SaabFAN/OpenSource-HW-RF-Signal-Generator-OSHW-RFSG-/Pictures/RF-Board_Rev1-Complete with Mods.jpg

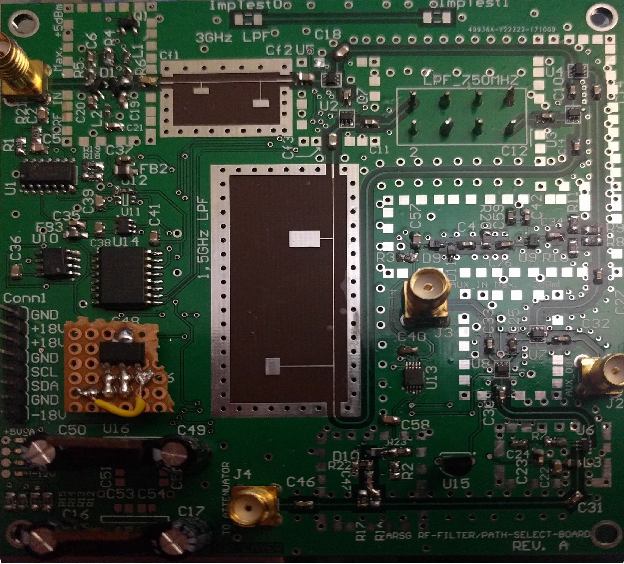
Pictures/RF-Board_Rev1-Complete with Mods.jpg
