SaabFAN/OpenSource-HW-RF-Signal-Generator-OSHW-RFSG-/Pictures/SignalGen_UI-Mockup.jpg

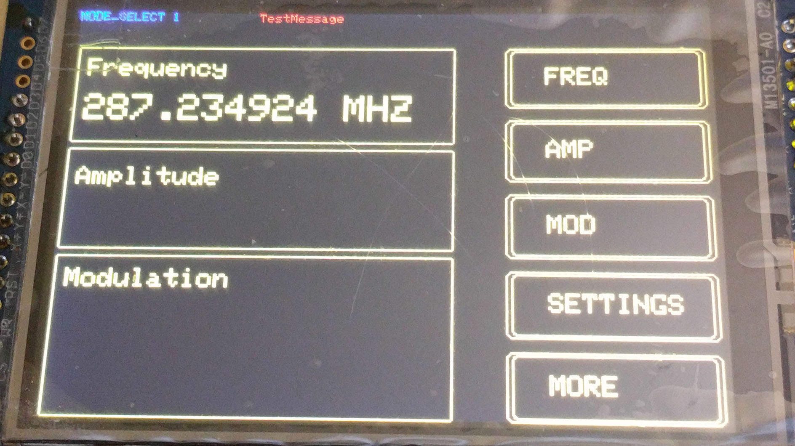
Pictures/SignalGen_UI-Mockup.jpg
