SaabFAN/OpenSource-HW-RF-Signal-Generator-OSHW-RFSG-/README.md

# OpenSource-HW-RF-Signal-Generator-OSHW-RFSG-
This is a open source hardware (and software) RF Signal Generator using readily available off the shelf-components. 

Corresponding EEVBlog Forum-Thread: http://www.eevblog.com/forum/oshw/open-source-hw-rf-signal-generator/

More info coming soon
