SaabFAN/OpenSource-HW-RF-Signal-Generator-OSHW-RFSG-/Schematics/Processor-Board/Processor-Board_CPU.pdf

InputRESET PA⁷ 17 PB⁰ 18 PB¹ 19 PB²/BOOT¹ 20 PB¹⁰ 21 | JTCK/SWCLK ³⁷ PB¹¹ 22 PA¹⁵/JTDI 38 PA³ 13 | VSS_1 23 PA⁴ 14 | PB³/JTDO ³⁹ PA⁵ 15 | VDD_1 24 PA⁶ 16 | PB⁴/JNTRST ⁴⁰ PB⁵ ⁴¹ PB⁶ ⁴² PB⁷ ⁴³ BOOT⁰ ⁴⁴ PB⁸ ⁴⁵ PB⁹ ⁴⁶ VSS_3 47 VDD_3 48

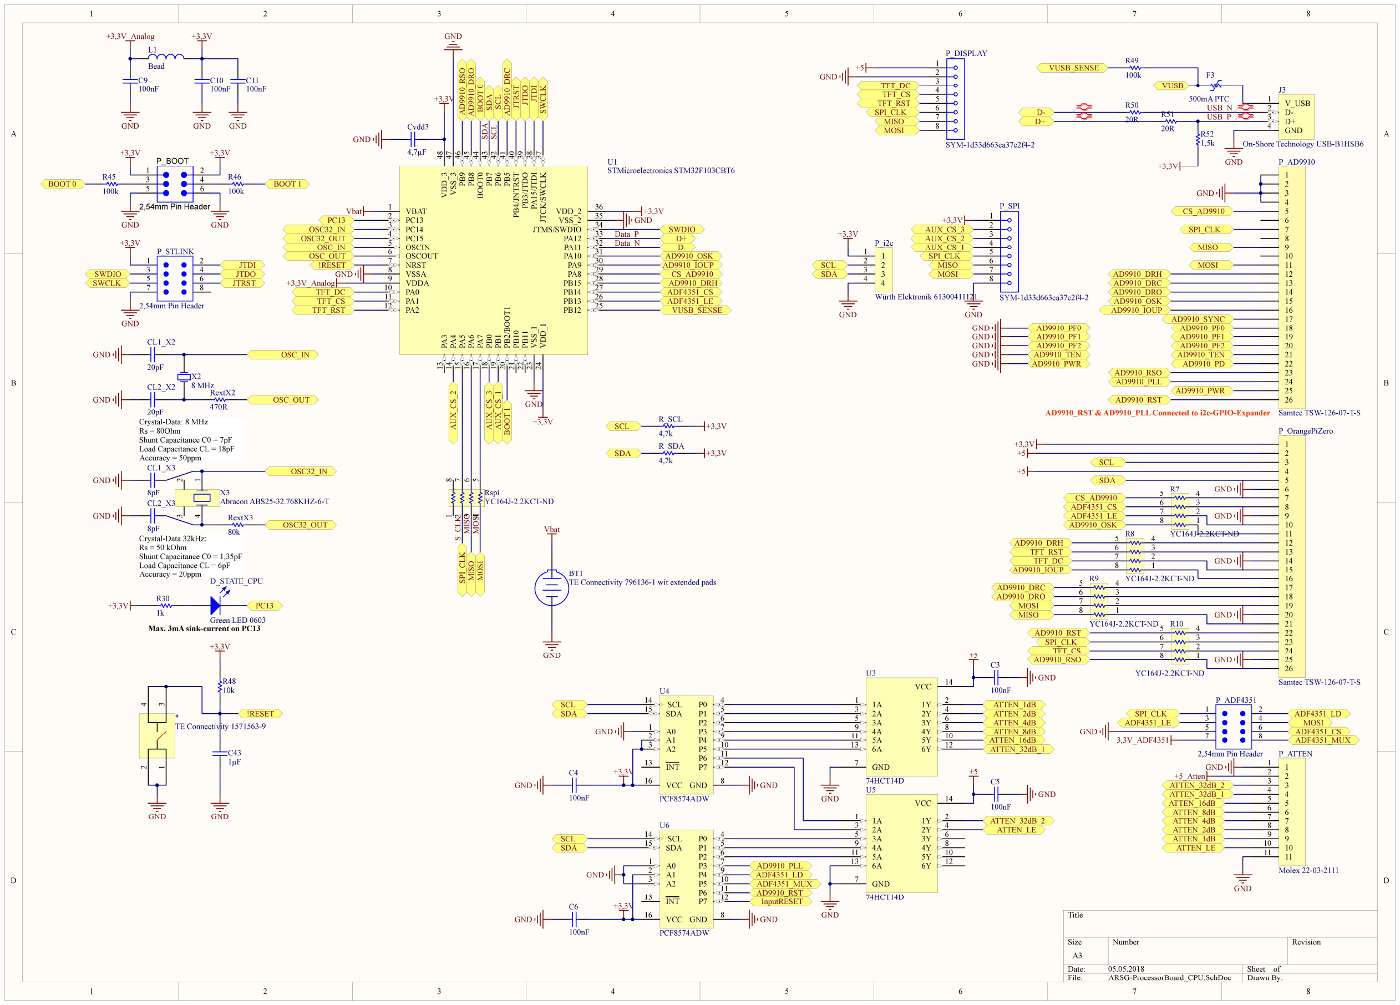
[picture p3: page 1]

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
Title

Size | Number | Revision
A3
Date: | 05.05.2018 | Sheet of
File: | ARSG-ProcessorBoard_CPU.SchDoc | Drawn By:

VBAT 1
PC13 2
PA12 33 PC14 3
PC15 4

JTMS/SWDIO 34

OSCIN 5
OSCOUT 6

VSS_2 35

NRST 7
VSSA 8

VDD_2 36

VDDA 9
PA0 10
PA1 11
PA2 12 | PB12 | 25 PB13 | 26 PB14 | 27 PB15 | 28 PA8 | 29 PA9 | 30 PA10 | 31 PA11 | 32

U1
STMicroelectronics STM32F103CBT6

RextX2
470R

CL1_X2

20pF
X2
CL2_X2 8 MHz

20pF

GND

GND

Crystal-Data: 8 MHz
Rs = 80Ohm
Shunt Capacitance C0 = 7pF Load Capacitance CL = 18pF Accuracy = 50ppm

Crystal-Data 32kHz:
Rs = 50 kOhm
Shunt Capacitance C0 = 1,35pF Load Capacitance CL = 6pF
Accuracy = 20ppm

CL1_X3

8pF
CL2_X3

8pF

GND

GND

OSC_IN
OSC_OUT

OSC32_IN
OSC32_OUT

V_USB

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
On-Shore Technology USB-B1HSB6

D+

D-

VUSB

D+
D-

R50
20R | R51
20R | R52
1,5k

GND
+3,3V

OSC_IN

OSC_OUT

+3,3V

GND

GND

GND

GND

GND

+3,3V

+3,3V

+3,3V

+3,3V_Analog

C10
100nF

C11
100nF

Cvdd3

4,7µF

C9
100nF

OSC32_IN

OSC32_OUT

GND

L1

Bead

C43
1µF

!RESET

!RESET

R48
10k

+3,3V

GND | GND
GND | GND

1 2
3 4
5 6

P_BOOT

2,54mm Pin Header

+3,3V

GND | GND | BOOT ⁰ | BOOT ¹
BOOT 0 | BOOT 1

+3,3V

R45
100k

R46
100k

SWDIO

SWDIO
SWCLK

JTDI
JTDO
JTRST

+3,3V

GND

1 2
3 4
5 6
7 8

P_STLINK

2,54mm Pin Header | JTDI JTDO JTRST | SWCLK SDA SCL MISO MOSI SPI_CLK

F3

500mA PTC

+3,3V_Analog

VUSB_SENSE

R49
100k

VUSB_SENSE

D_STATE_CPU

Green LED 0603

R30
1k
+3,3V | PC13

PC13

Max. 3mA sink-current on PC13 | S_CLK MISO MOSI SDA SCL

Data_N

Data_P

USB_P

USB_N

RextX3

80k ³ ² 4 1 | X3
Abracon ABS25-32.768KHZ-6-T | 1

2

34 58
7

6
Rspi
YC164J-2.2KCT-ND

4

3

2

1

*
TE Connectivity 1571563-9

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
P_AD9910

Samtec TSW-126-07-T-S

GND

CS_AD9910

MOSI

MISO

SPI_CLK

AD9910_DRC

AD9910_OSK

AD9910_SYNC

AD9910_PF1

AD9910_TEN

AD9910_RSO

AD9910_PWR
AD9910_RST

AD9910_PLL

AD9910_PD

AD9910_PF2

AD9910_PF0

AD9910_IOUP

AD9910_DRO

CS_AD9910 | AD9910_DRH

AD9910_OSK
AD9910_IOUP

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
P_OrangePiZero

Samtec TSW-126-07-T-S

+5

+3,3V

+5

GND

SCL

SDA

CS_AD9910

GND
AD9910_OSK

AD9910_RST

AD9910_IOUP

ADF4351_CS
ADF4351_LE

ADF4351_CS
ADF4351_LE

GND

GND

GND

TFT_DC

TFT_CS

TFT_RST

MOSI
MISO

SPI_CLK

TFT_DC
TFT_CS
TFT_RST

1 2
3 4
5 6
7 8

P_ADF4351

2,54mm Pin Header

MOSI

SPI_CLK

ADF4351_CS

ADF4351_LE

ADF4351_MUX

ADF4351_LD

3,3V_ADF4351

GND

1A 1

1Y 2
2A 3

2Y 4
3A 5

3Y 6

GND 7

4Y 8

4A 9
5Y | 10 5A 11
6Y | 12 6A 13
VCC | 14

U3

74HCT14D

1A 1

1Y 2
2A 3

2Y 4
3A 5

3Y 6

GND 7

4Y 8

4A 9
5Y | 10 5A 11
6Y | 12 6A 13
VCC | 14

U5

74HCT14D

A0 1
A1 2
A2 3
P0 | 4
P1 | 5
P2 | 6
P3 | 7
GND | 8
P4 | 9
P5 | 10
P6 | 11
P7 | 12 INT 13

SCL 14
SDA 15

VCC 16

U4

PCF8574ADW

ATTEN_1dB
ATTEN_2dB
ATTEN_4dB
ATTEN_8dB
ATTEN_16dB
ATTEN_32dB_1

ATTEN_32dB_2

ATTEN_LE AD⁹⁹¹⁰_RSO AD⁹⁹¹⁰_DRO | AD⁹⁹¹⁰_DRC

AD9910_DRH

AD9910_DRC

AD9910_RSO

AD9910_DRO

AD9910_DRH

A0 1
A1 2
A2 3
P0 | 4
P1 | 5
P2 | 6
P3 | 7
GND | 8
P4 | 9
P5 | 10
P6 | 11
P7 | 12 INT 13

SCL 14
SDA 15

VCC 16

U6

PCF8574ADW

GND

GND

C3

100nF

C5

100nF

C4

100nF

C6

100nF

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
+3,3V

+3,3V

GND

GND
ADF4351_MUX

ADF4351_LD

AD9910_RST

AD9910_RST & AD9910_PLL Connected to i2c-GPIO-Expander

AD9910_PLL

ATTEN_1dB

ATTEN_2dB

ATTEN_4dB

ATTEN_8dB

ATTEN_16dB

ATTEN_32dB_1

ATTEN_32dB_2

ATTEN_LE

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
P_ATTEN

Molex 22-03-2111

GND

GND
+5_Atten

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
YC164J-2.2KCT-ND

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
YC164J-2.2KCT-ND

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
YC164J-2.2KCT-ND

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
YC164J-2.2KCT-ND

TFT_DC
TFT_CS
TFT_RST

MOSI

MISO

SPI_CLK

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
P_DISPLAY

SYM-1d33d663ca37c2f4-2

SCL

SDA

+3,3V

+3,3V

R_SCL
4,7k
R_SDA
4,7k

AD9910_PF1

AD9910_TEN
AD9910_PWR

AD9910_PF2

GND | AD9910_PF0
GND
GND
GND
GND

BT1
TE Connectivity 796136-1 wit extended pads

Vbat

Vbat

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
P_i2c

Würth Elektronik 61300411121

MOSI

MISO

SPI_CLK

GND | GND

SCL

SDA AUX_CS_2 | AUX_CS_3 AUX_CS_1

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
P_SPI

SYM-1d33d663ca37c2f4-2

AUX_CS_1

AUX_CS_2

AUX_CS_3 +3,3V

+3,3V
