SaabFAN/OpenSource-HW-RF-Signal-Generator-OSHW-RFSG-/Schematics/Processor-Board/Processor-Board_PSU.pdf

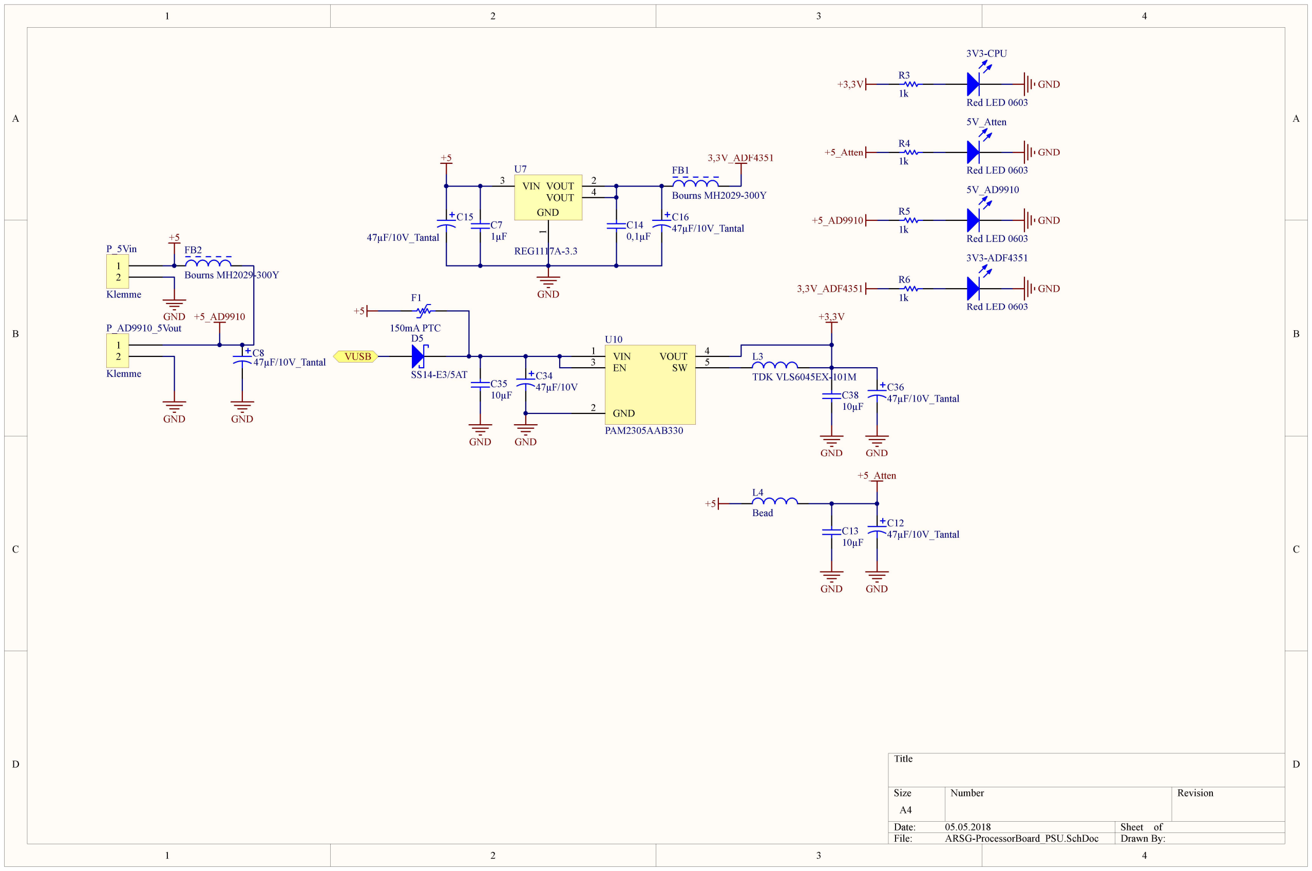
[picture p4: page 1]

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
Title

Size | Number | Revision
A4
Date: | 05.05.2018 | Sheet of
File: | ARSG-ProcessorBoard_PSU.SchDoc | Drawn By:

+3,3V

VUSB

+5

GND

C35
10µF

GND

C38
10µF

GND

C36
47µF/10V_Tantal

GND

D5

SS14-E3/5AT

VIN 1

GND 2

EN 3

VOUT | 4
SW | 5

U10

PAM2305AAB330

C34
47µF/10V

F1

150mA PTC | 1 VOUT | 2 VIN 3
VOUT | 4

GND

U7

REG1117A-3.3
1
2

P_5Vin

Klemme

C7
1µF

C14
0,1µF

C16
47µF/10V_Tantal

FB1

Bourns MH2029-300Y

C15

47µF/10V_Tantal

GND

+5 | 3,3V_ADF4351

+5

GND

1
2

P_AD9910_5Vout

Klemme

FB2

Bourns MH2029-300Y

C8
47µF/10V_Tantal
GND | GND

L3

TDK VLS6045EX-101M

L4

Bead

+5
C12
47µF/10V_Tantal C13
10µF

GND GND

+5_Atten

3V3-CPU

Red LED 0603

R3
1k

+3,3V

3V3-ADF4351

Red LED 0603

R6
1k

5V_AD9910

Red LED 0603

R5
1k

3,3V_ADF4351

+5_AD9910

+5_AD9910

+5_Atten

5V_Atten

Red LED 0603

R4
1k

GND

GND

GND

GND
