SaabFAN/OpenSource-HW-RF-Signal-Generator-OSHW-RFSG-/Pictures/Board-Arrangement.jpg

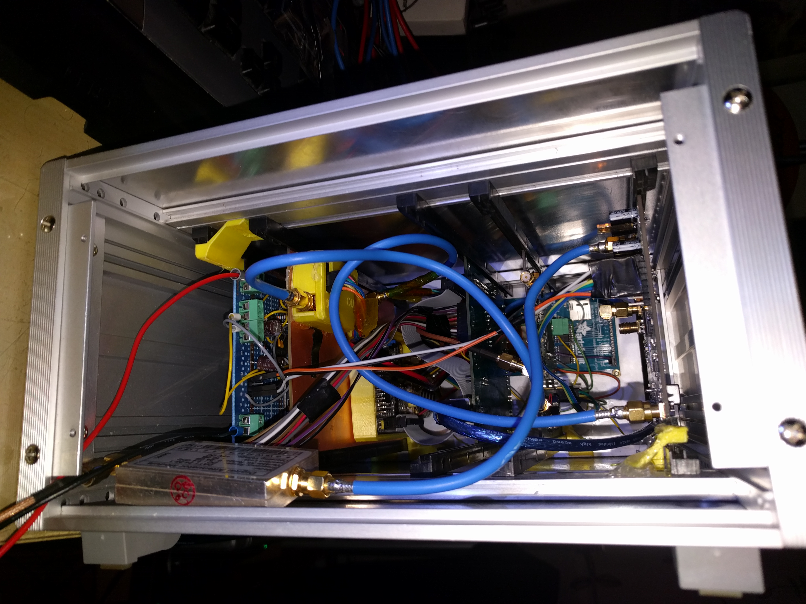
Pictures/Board-Arrangement.jpg
