SaabFAN/OpenSource-HW-RF-Signal-Generator-OSHW-RFSG-/Pictures/Bodge for SPI-Data and SPI-Clock Lines.png

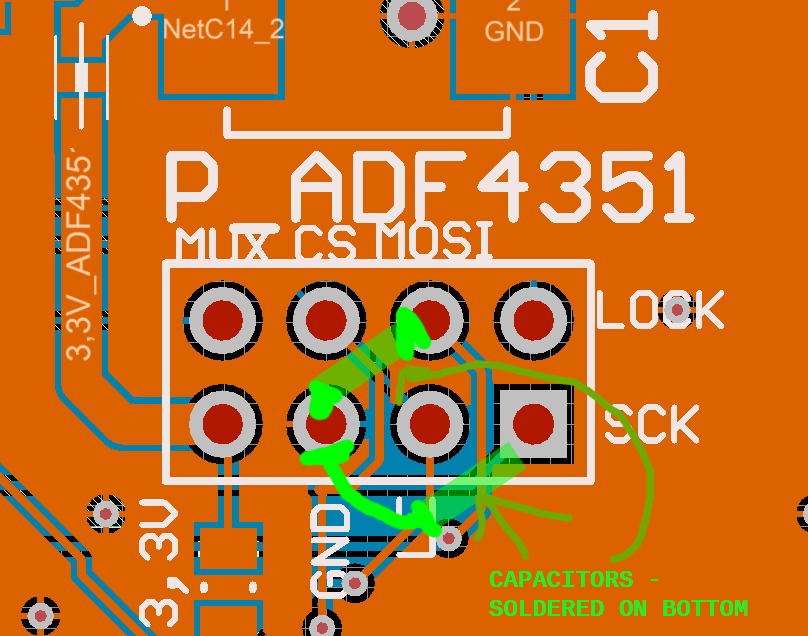
Pictures/Bodge for SPI-Data and SPI-Clock Lines.png
