SaabFAN/OpenSource-HW-RF-Signal-Generator-OSHW-RFSG-/Schematics/Analog Board/RF-Board_Schematic_Part1.jpg

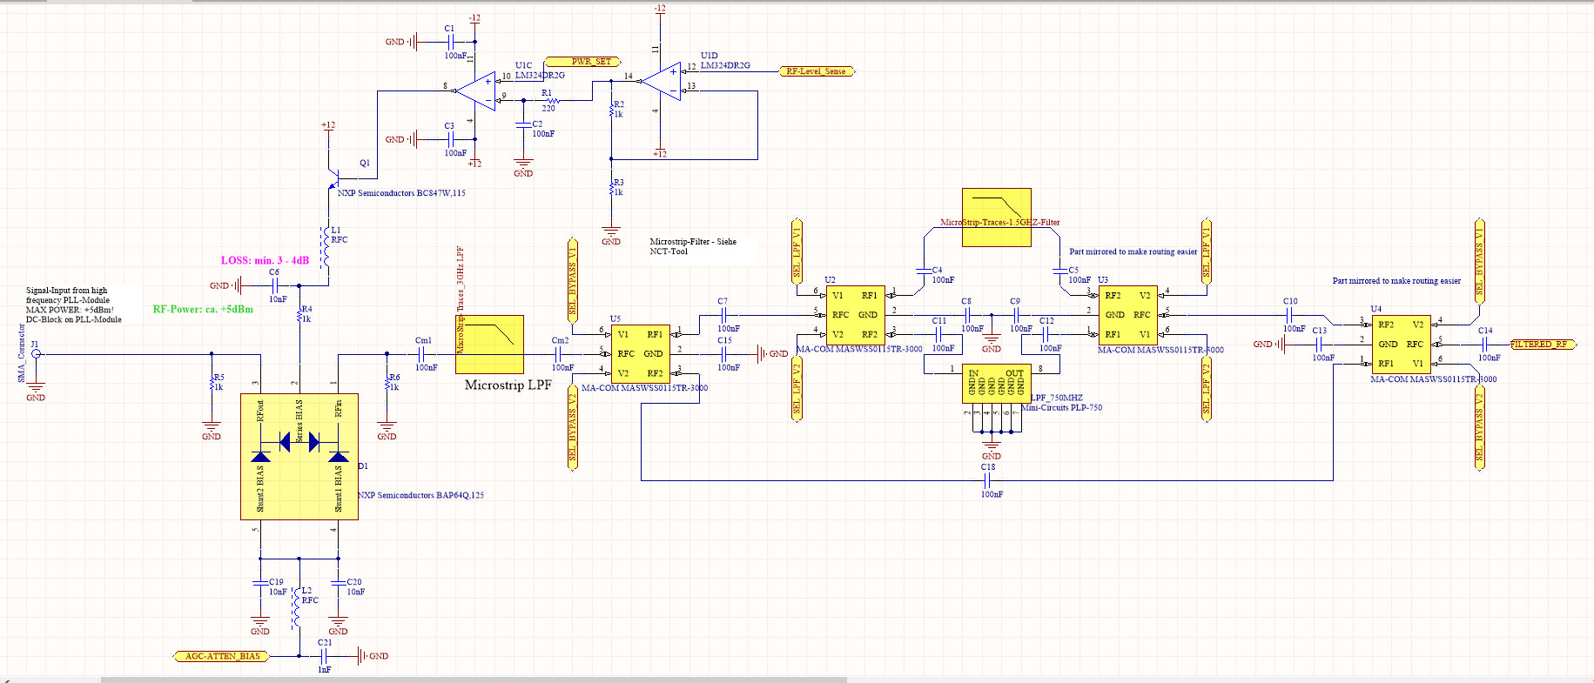
Schematics/Analog Board/RF-Board_Schematic_Part1.jpg
