SaabFAN/OpenSource-HW-RF-Signal-Generator-OSHW-RFSG-/Schematics/Analog Board/RF-Board_Schematic_Part2.jpg

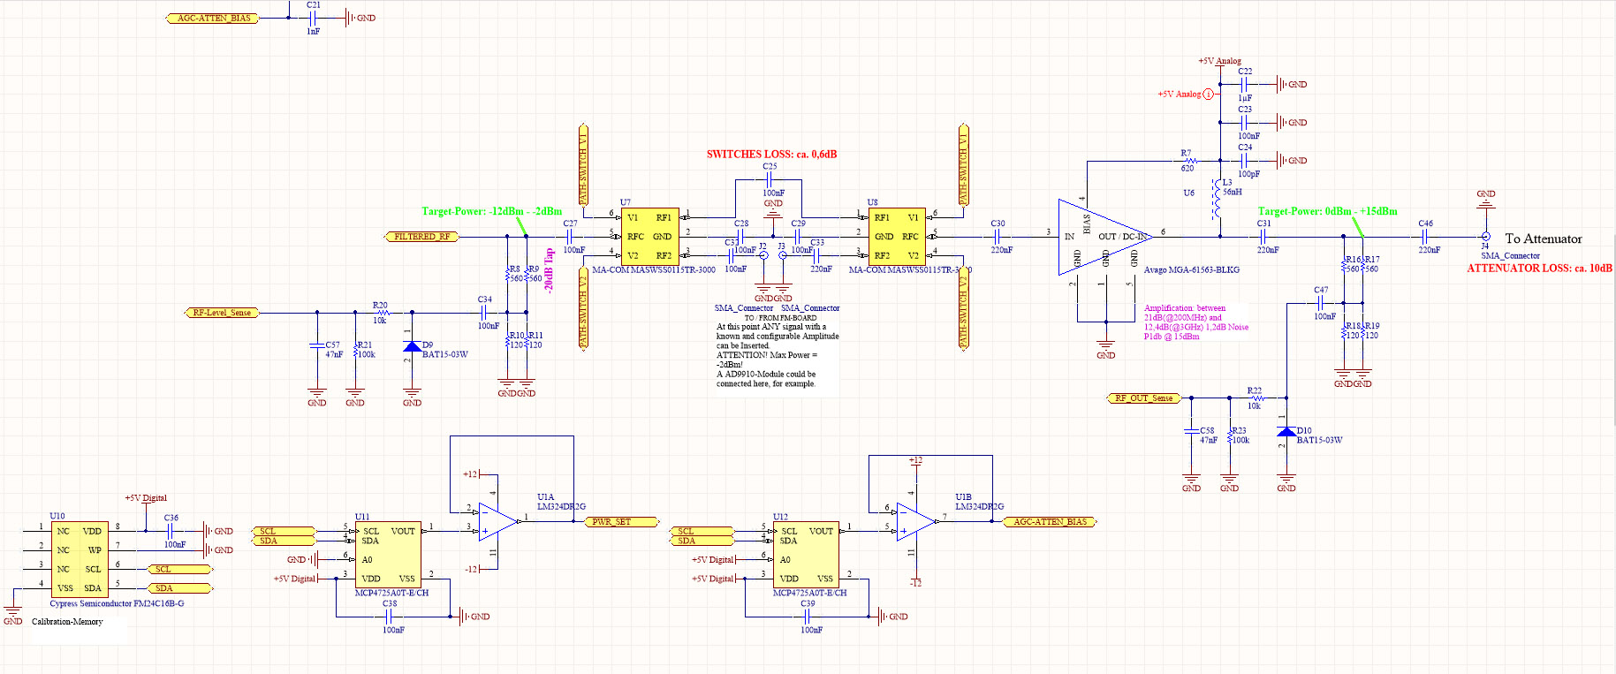
Schematics/Analog Board/RF-Board_Schematic_Part2.jpg
