SaabFAN/OpenSource-HW-RF-Signal-Generator-OSHW-RFSG-/Schematics/Analog Board/RF_LEVEL_SENSE-Detector + Amp.jpg

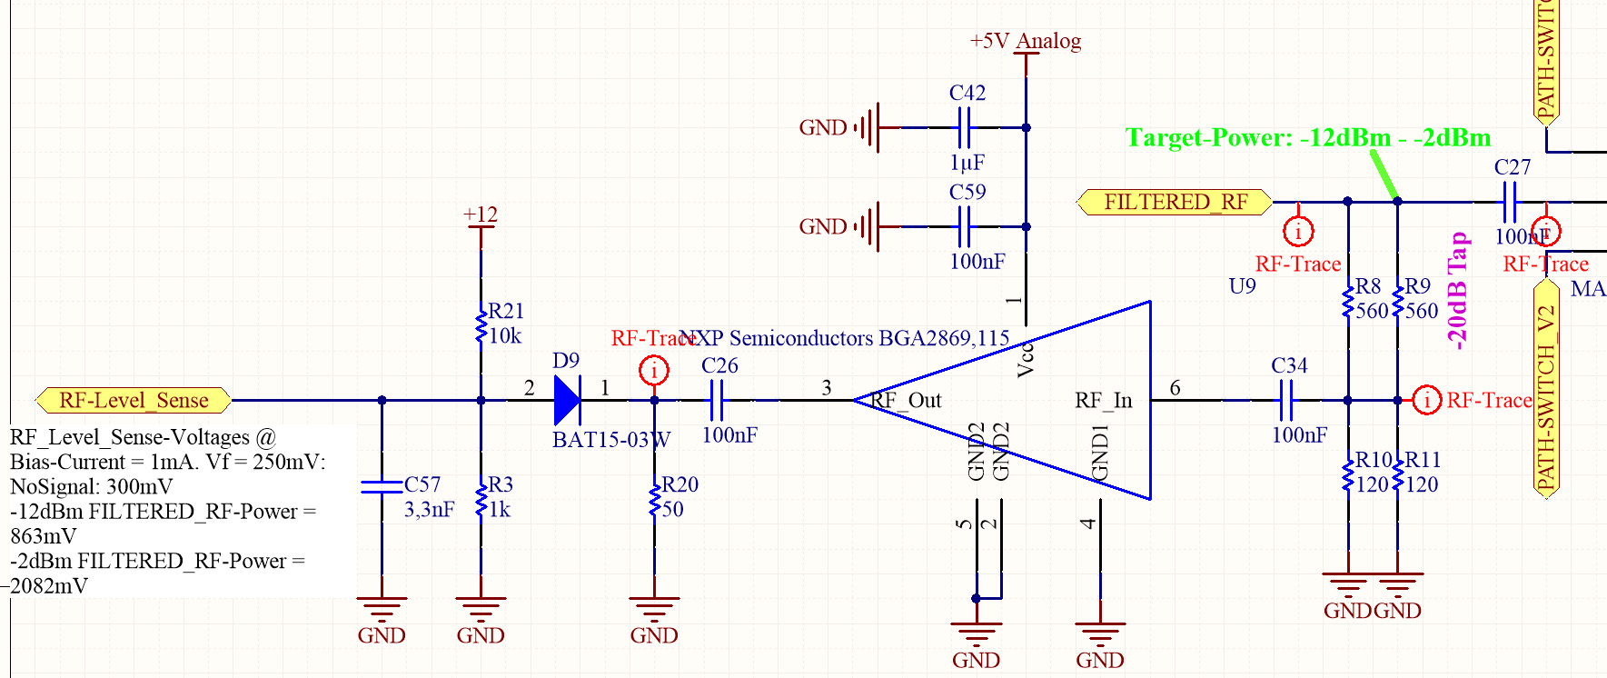
Schematics/Analog Board/RF_LEVEL_SENSE-Detector + Amp.jpg
