SaabFAN/OpenSource-HW-RF-Signal-Generator-OSHW-RFSG-/Schematics/Analog Board/RF_OUT_SENSE-Detector.jpg

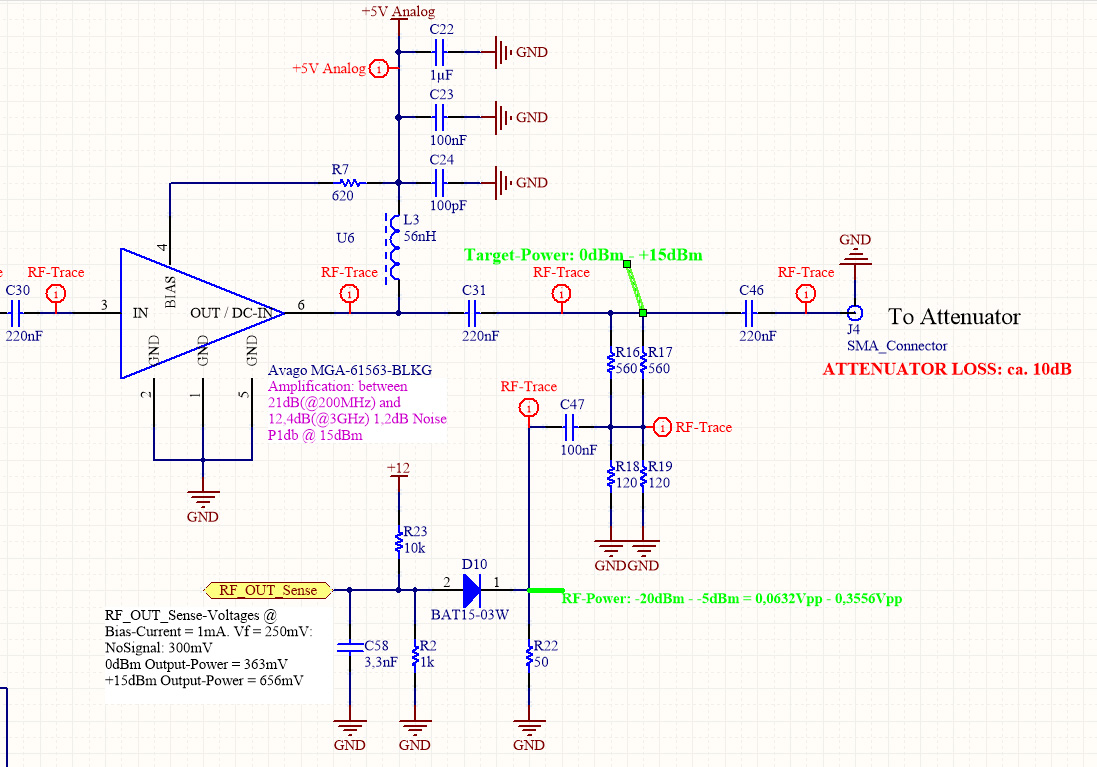
Schematics/Analog Board/RF_OUT_SENSE-Detector.jpg
