SaabFAN/OpenSource-HW-RF-Signal-Generator-OSHW-RFSG-/STL-Files/InternalStructure/Case_Internal_Bottom.stl

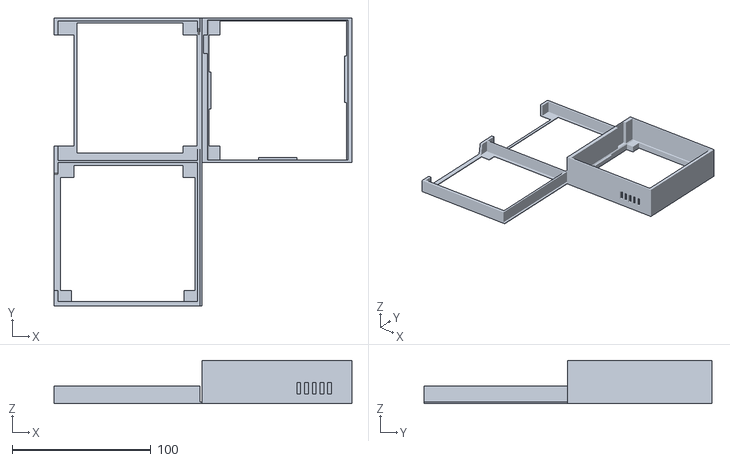
[picture p13: CAD file, 2018-06-29]
STL-Files/InternalStructure/Case_Internal_Bottom.stl
214.4 x 207.0 x 31.2
