SaabFAN/OpenSource-HW-RF-Signal-Generator-OSHW-RFSG-/STL-Files/Halteklammer.stl

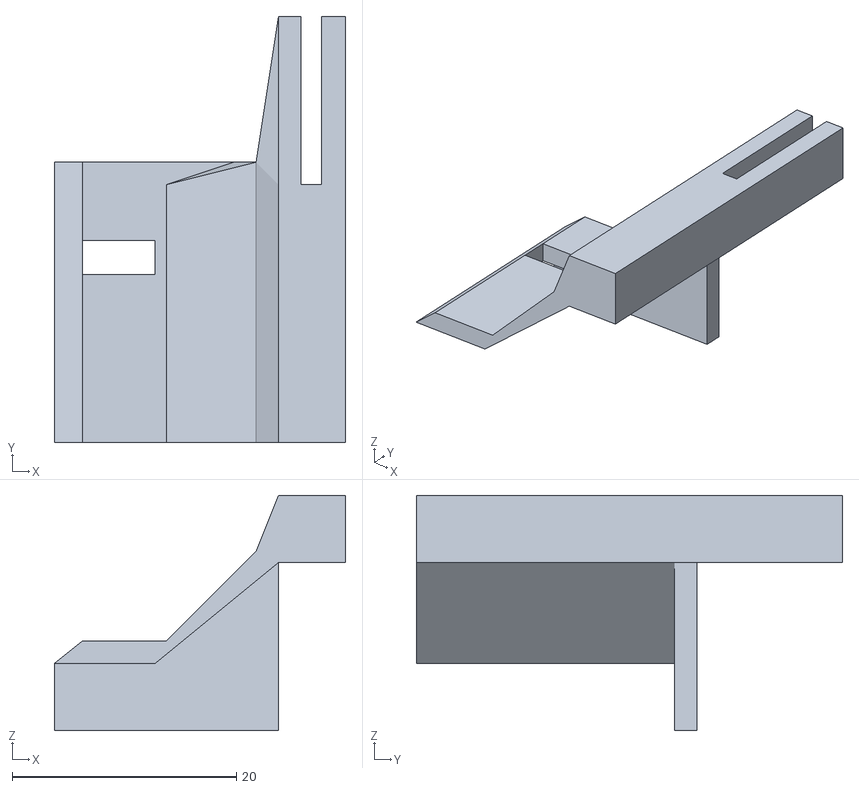
[picture p14: CAD file, 2018-05-08]
STL-Files/Halteklammer.stl
26.0 x 38.0 x 21.0
