SaabFAN/OpenSource-HW-RF-Signal-Generator-OSHW-RFSG-/STL-Files/Max1000-Case_Low.stl

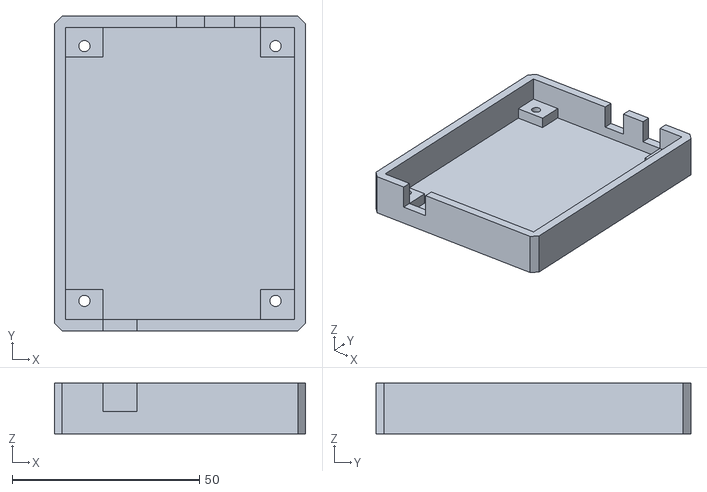
[picture p15: CAD file, 2018-05-08]
STL-Files/Max1000-Case_Low.stl
67.0 x 84.0 x 13.5
