SaabFAN/OpenSource-HW-RF-Signal-Generator-OSHW-RFSG-/STL-Files/AD9910_LowCase.stl

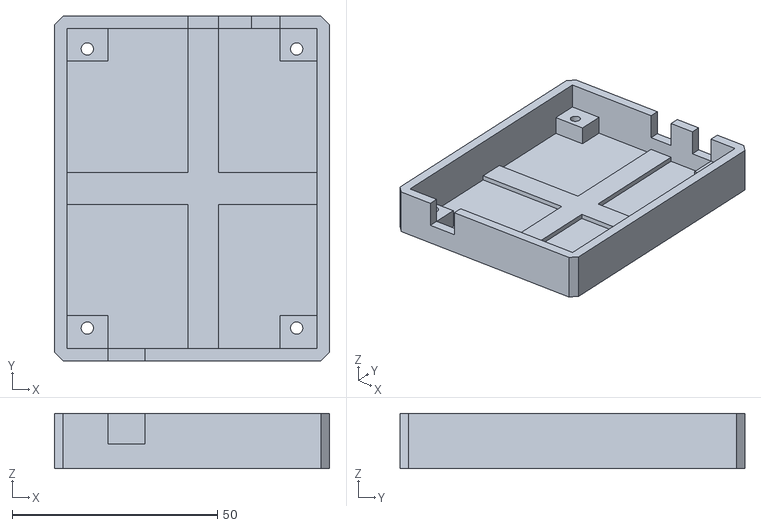
[picture p16: CAD file, 2018-05-08]
STL-Files/AD9910_LowCase.stl
67.0 x 84.0 x 13.5
