SaabFAN/OpenSource-HW-RF-Signal-Generator-OSHW-RFSG-/STL-Files/Halteklammer_Kurz.stl

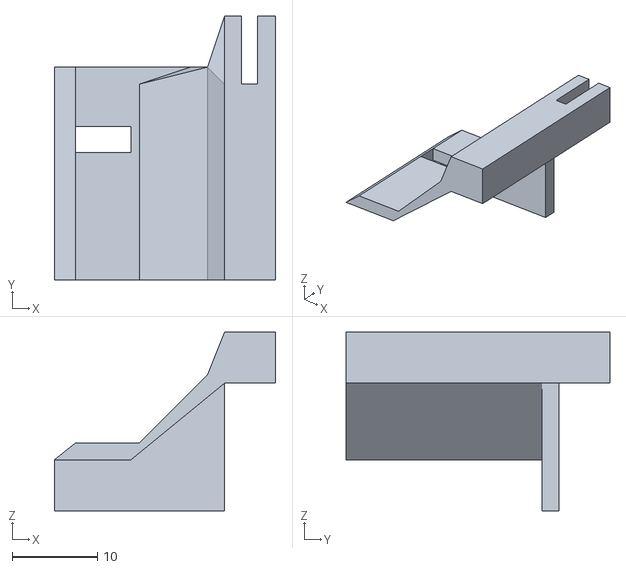
[picture p17: CAD file, 2018-05-08]
STL-Files/Halteklammer_Kurz.stl
26.0 x 31.0 x 21.0
