SaabFAN/OpenSource-HW-RF-Signal-Generator-OSHW-RFSG-/STL-Files/AD4351-Case_Low.stl

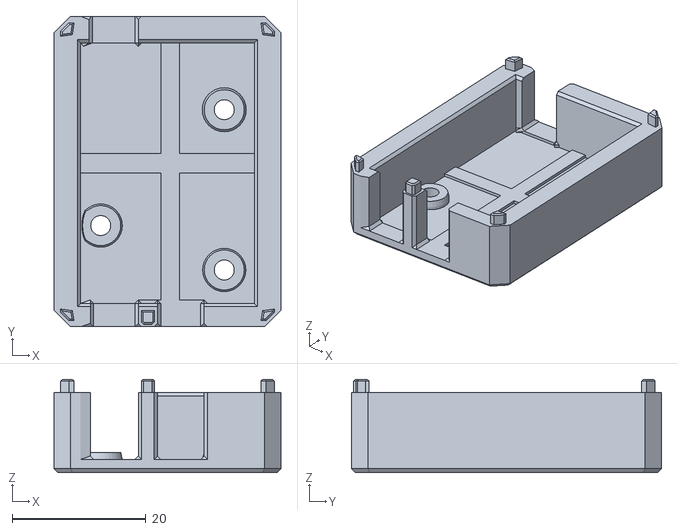
[picture p18: CAD file, 2018-05-08]
STL-Files/AD4351-Case_Low.stl
34.0 x 46.5 x 14.0
