SaabFAN/OpenSource-HW-RF-Signal-Generator-OSHW-RFSG-/Tests and Measurements/ADF4351 raw Output/200MHz -10dBm Ref.png

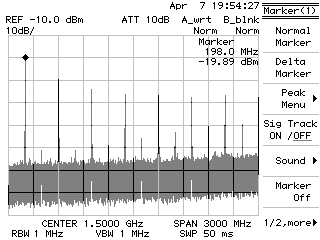
Tests and Measurements/ADF4351 raw Output/200MHz -10dBm Ref.png
