SaabFAN/OpenSource-HW-RF-Signal-Generator-OSHW-RFSG-/Tests and Measurements/ADF4351 raw Output/1500MHz -10dBm Ref.png

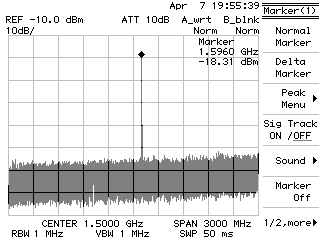
Tests and Measurements/ADF4351 raw Output/1500MHz -10dBm Ref.png
