SaabFAN/OpenSource-HW-RF-Signal-Generator-OSHW-RFSG-/Schematics/Keyboard with Atmega328P.pdf

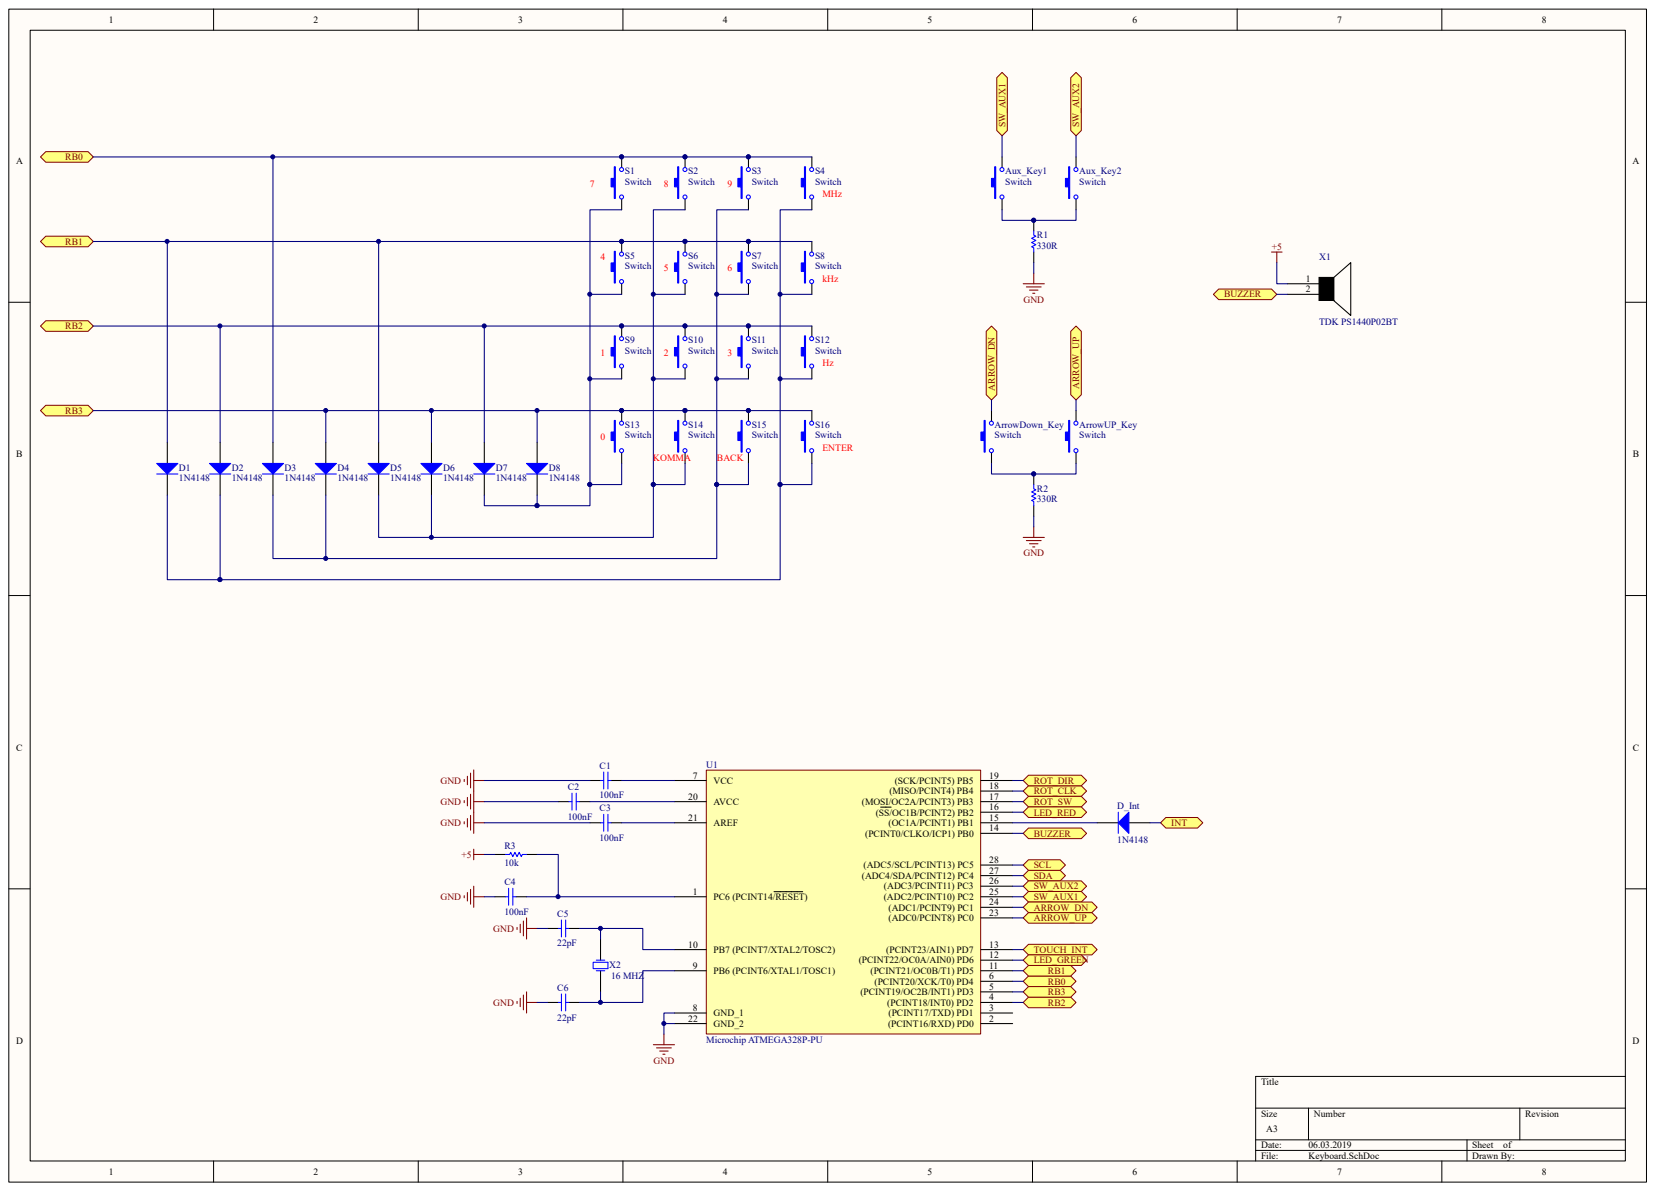
[picture p23: page 1]
