SaabFAN/OpenSource-HW-RF-Signal-Generator-OSHW-RFSG-/Schematics/Processor-Board/Processor-Board_InputCtrl.pdf

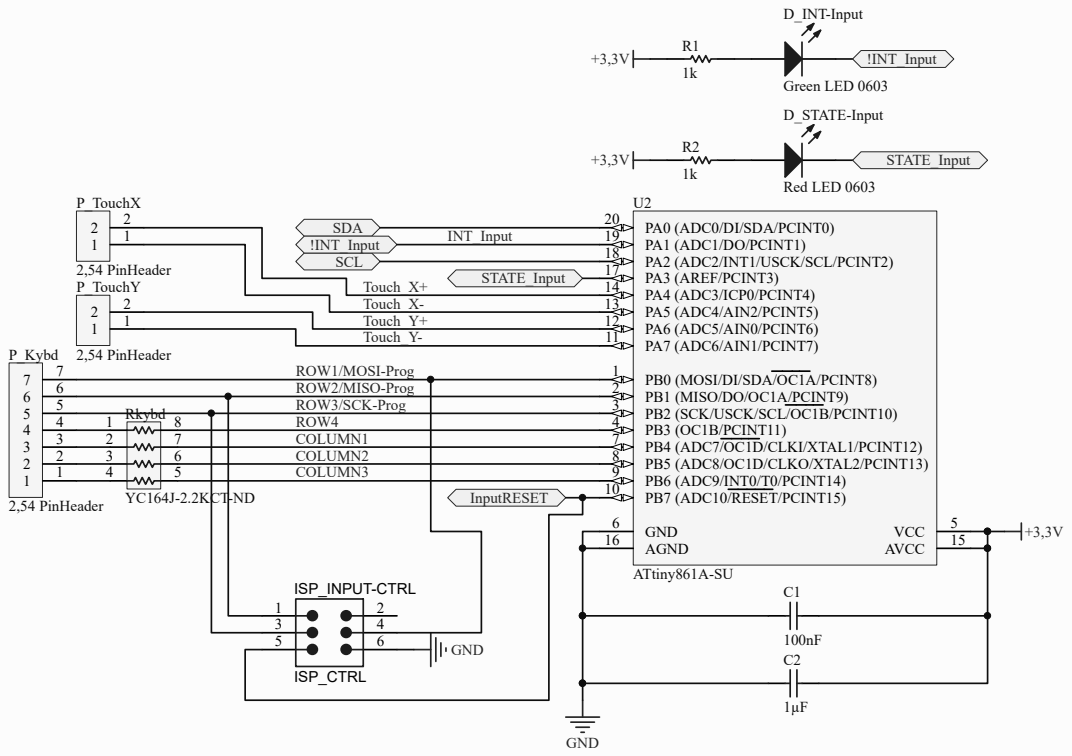
[picture p24: page 1]
Title; Size; Number; Revision; Date:; Sheet of; File:; ARSG-ProcessorBoard_KeyboardController.SchDoc Drawn By:; PB7 (ADC10/RESET/PCINT15) 10; PB6 (ADC9/INT0/T0/PCINT14) 9; VCC; PA0 (ADC0/DI/SDA/PCINT0) 20 PA1 (ADC1/DO/PCINT1) 19; PA4 (ADC3/ICP0/PCINT4) 14; AVCC; 15 AGND 16; PA2 (ADC2/INT1/USCK/SCL/PCINT2) 18; PA5 (ADC4/AIN2/PCINT5) 13 PA6 (ADC5/AIN0/PCINT6) 12 PA7 (ADC6/AIN1/PCINT7) 11; GND 6; PA3 (AREF/PCINT3) 17; ATtiny861A-SU; SDA; SCL; P_Kybd; 2,54 PinHeader; InputRESET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

PB0 (MOSI/DI/SDA/OC1A/PCINT8) 1
PB1 (MISO/DO/OC1A/PCINT9) 2
PB2 (SCK/USCK/SCL/OC1B/PCINT10) 3
PB3 (OC1B/PCINT11) 4
PB4 (ADC7/OC1D/CLKI/XTAL1/PCINT12) 7
PB5 (ADC8/OC1D/CLKO/XTAL2/PCINT13) 8
