SaabFAN/OpenSource-HW-RF-Signal-Generator-OSHW-RFSG-/Firmware/ARSG_STM32_Version4/SignalControls/AD9910Driver.h

/*
 * AD9910Driver.h
 *
 *  Created on: 16.03.2019
 *      Author: voyag
 */

#ifndef AD9910DRIVER_H_
#define AD9910DRIVER_H_

#include "Arduino.h"
#include "Wire.h"
#include "SPI.h"

#define AD9910_CS PA8
#define AD9910_IOUP PA9
#define AD9910_OSK PA10
#define AD9910_DRH PB15
#define AD9910_DRC PB5
#define AD9910_DRO PB8
#define AD9910_RSO PB9
#define AD9910_PLL 0x08 // Bitmask for the second GPIO-Expander - PLL-Lock Detect of AD9910. LOW = UNLOCK
#define AD9910_RST 0x40 // Bitmask for the second GPIO-Expander - I/O-Reset Pin of AD9910

class AD9910Driver {
public:
	AD9910Driver();
	virtual ~AD9910Driver();
	bool Init(unsigned long reference_frequency, char GPIO_ADR);
	void SetMode(char mode);
	void Configure(int selector, int value);
	bool SetAmplitude(float amplitude, bool decibels);
	void SetFrequency(unsigned long frequency);
	void SetPhase(unsigned long phaseOffset);
	bool CheckLock();
	bool CheckMux();
	unsigned long GetFrequency();
	char GetAmplitude();
	int GetPhase();
	void Dump();
private:
	char _GPIO_ADR;
	void SendCFR();
	void WriteAD9910(char AD9910_INST);
	long freq_Old;
};

#endif /* AD9910DRIVER_H_ */
