SaabFAN/OpenSource-HW-RF-Signal-Generator-OSHW-RFSG-/Firmware/CPLD_GlueLogic/i2c_CORE/i2c_CORE_inst.v

	i2c_CORE u0 (
		.a0           (<connected-to-a0>),           //           a0.a0
		.a1           (<connected-to-a1>),           //           a1.a1
		.a2           (<connected-to-a2>),           //           a2.a2
		.scl          (<connected-to-scl>),          //          scl.scl
		.sda          (<connected-to-sda>),          //          sda.sda
		.osc          (<connected-to-osc>),          //          osc.osc
		.global_reset (<connected-to-global_reset>)  // global_reset.global_reset
	);
