SaabFAN/OpenSource-HW-RF-Signal-Generator-OSHW-RFSG-/(commit log)

2018-05-08 Added basic project-files, including schematics.
    [AD4351-Case_Low.stl, AD4351-Case_Top.stl, AD9910_LowCase.stl, ElsieConfiguration.CFG, Halteklammer.stl, Halteklammer_Kurz.stl, Max1000-Case_Low.stl]
2018-06-29 Added Firmware-Sources and 3D-Model for the internal Case-Structure.
    [Case_Internal_Bottom.stl]
2018-07-01 Picture added, detailing the Workaround with the capacitors on the SPI Data and Clock-Lines.
2018-09-14 Added code to help debugging the AGC-Circuits
2019-07-15 Re-Commit of all files, based on new Deveopment-Branch started in July 2019
    [ALC_Settings für 0 dBm.ods, ARSG_GlueLogic.smp_dump.txt, Keyboard-Decode.ods, i2c_CORE.csv]
2019-11-25 ADF4351-Control now working reliably.
    AD9910-Control partially working:
    - Frequency-Control working reliably - Frequency-Accuracy does not always meet desired accuracy due to rounding-errors (Compiler-Error?)
    - CFR-Programming and/or Register-Dump potentially buggy - Must be checked again with all the other SPI-Hardware disconnected to make sure there's no signal-integrity problem.
    - Amplitude Scale Factor Works partially: Plain Factor-Scaling works, but Factor-Scaling in Decibel buggy (wrong Formula?)
    TODO (AD9910-Driver):
    - Test Phase Offset-Word Control
    - Make sure CFR-Programming works reliably
    - Add frequency dependent Amplitude Scaling-Factors to keep amplitude constant
    - IMPORTANT: AD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
    [AD9910Driver.cpp]
